phucmilo/Smart-Home-AI/SmartHome/SmartHome/Docs/SmartHome_Diagrams_page01_overview.png

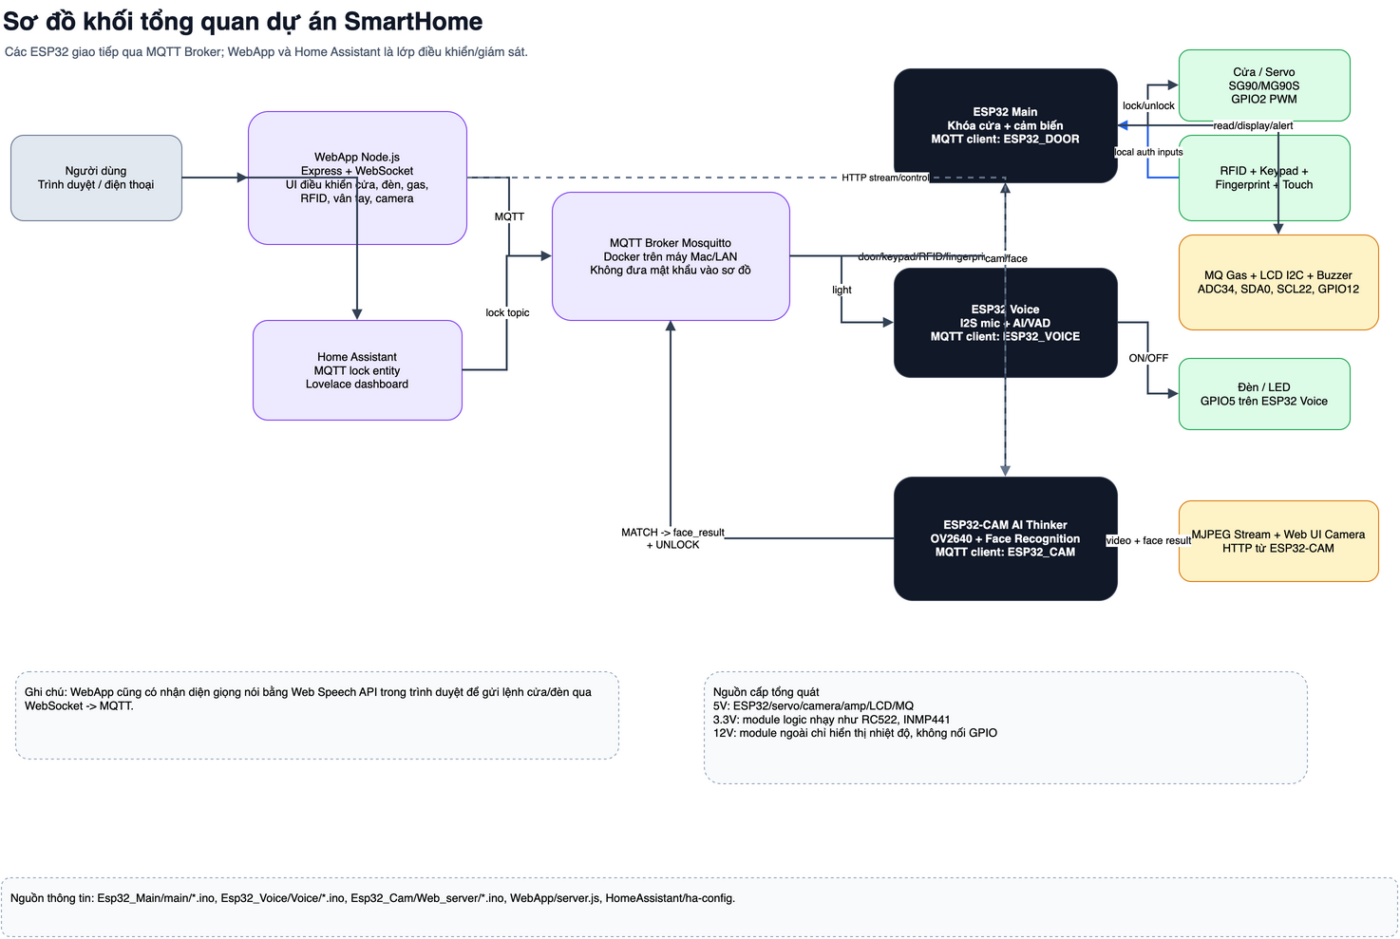
SmartHome/SmartHome/Docs/SmartHome_Diagrams_page01_overview.png
