phucmilo/Smart-Home-AI/SmartHome/SmartHome/Docs/SmartHome_Diagrams_page07_pin_main.png

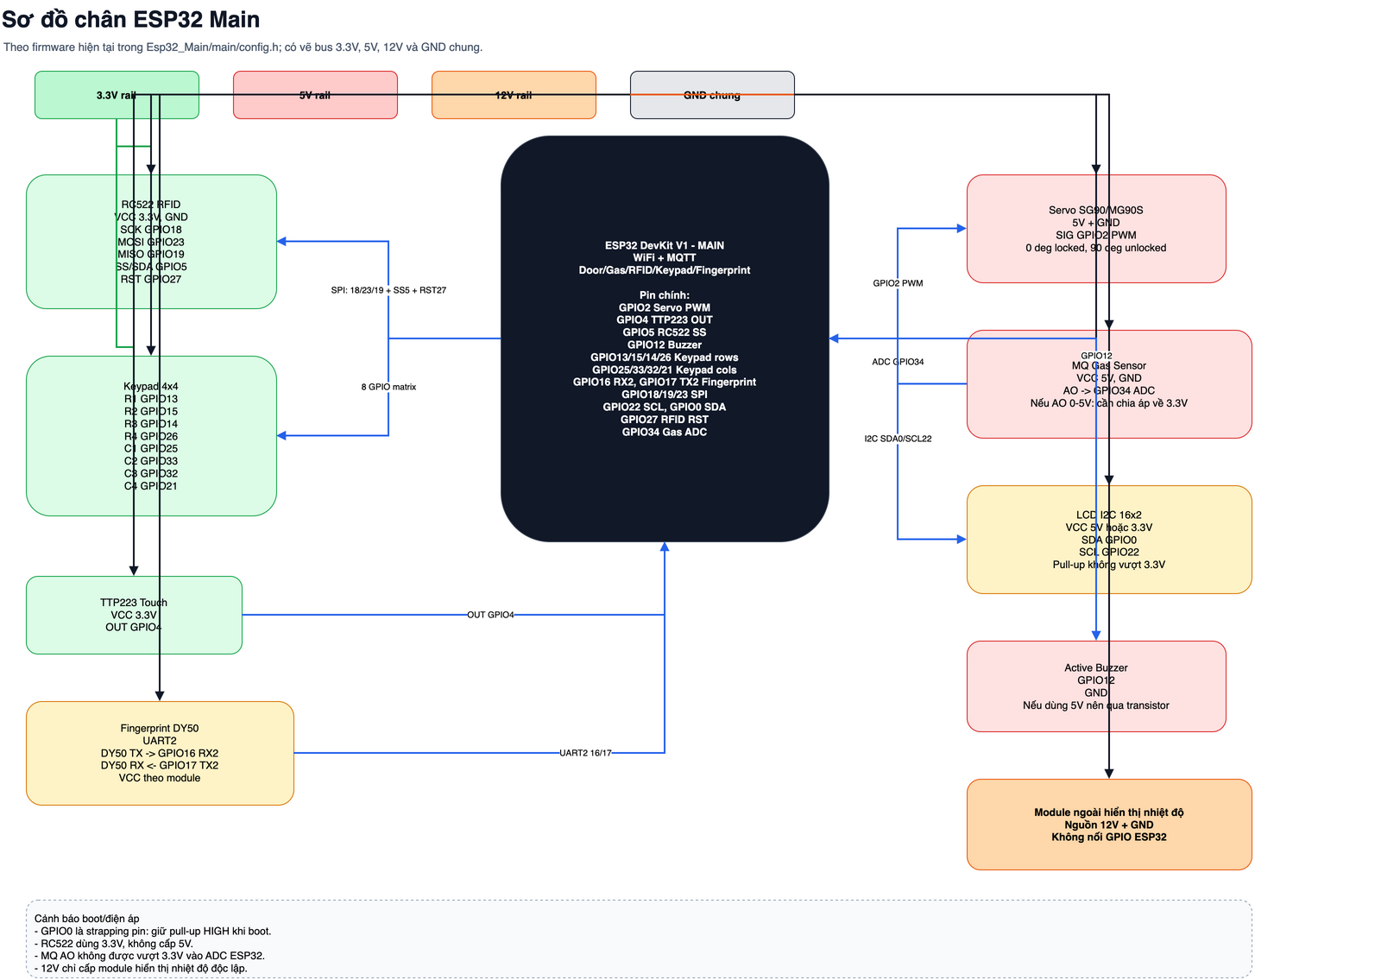
SmartHome/SmartHome/Docs/SmartHome_Diagrams_page07_pin_main.png
