phucmilo/Smart-Home-AI/SmartHome/SmartHome/Docs/SmartHome_Diagrams_page16_voice_vad.png

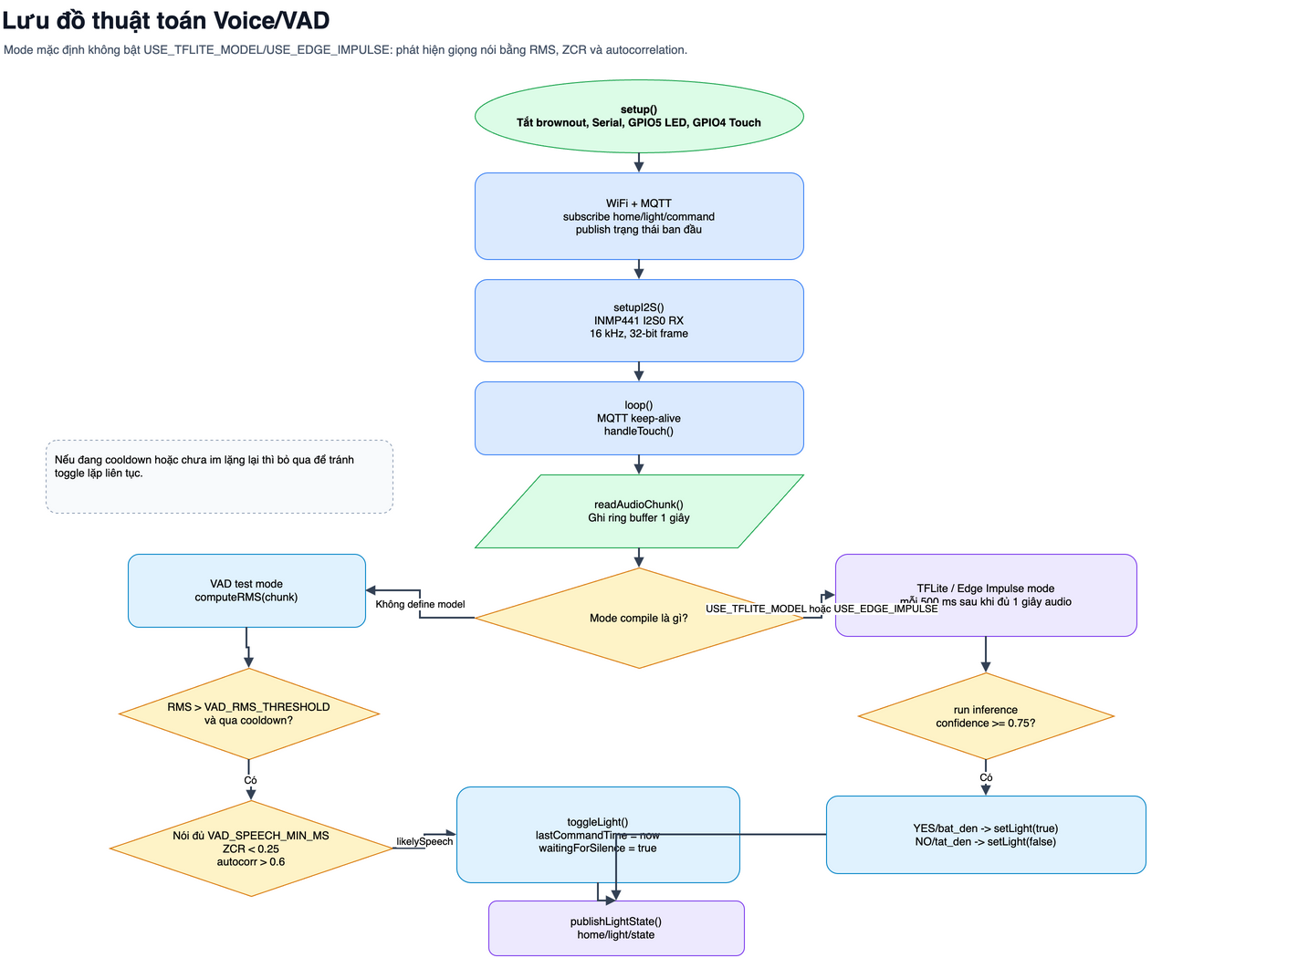
SmartHome/SmartHome/Docs/SmartHome_Diagrams_page16_voice_vad.png
