phucmilo/Smart-Home-AI/SmartHome/SmartHome/Docs/SmartHome_Diagrams.pdf

# Sơ đồ khối tổng quan dự án SmartHome

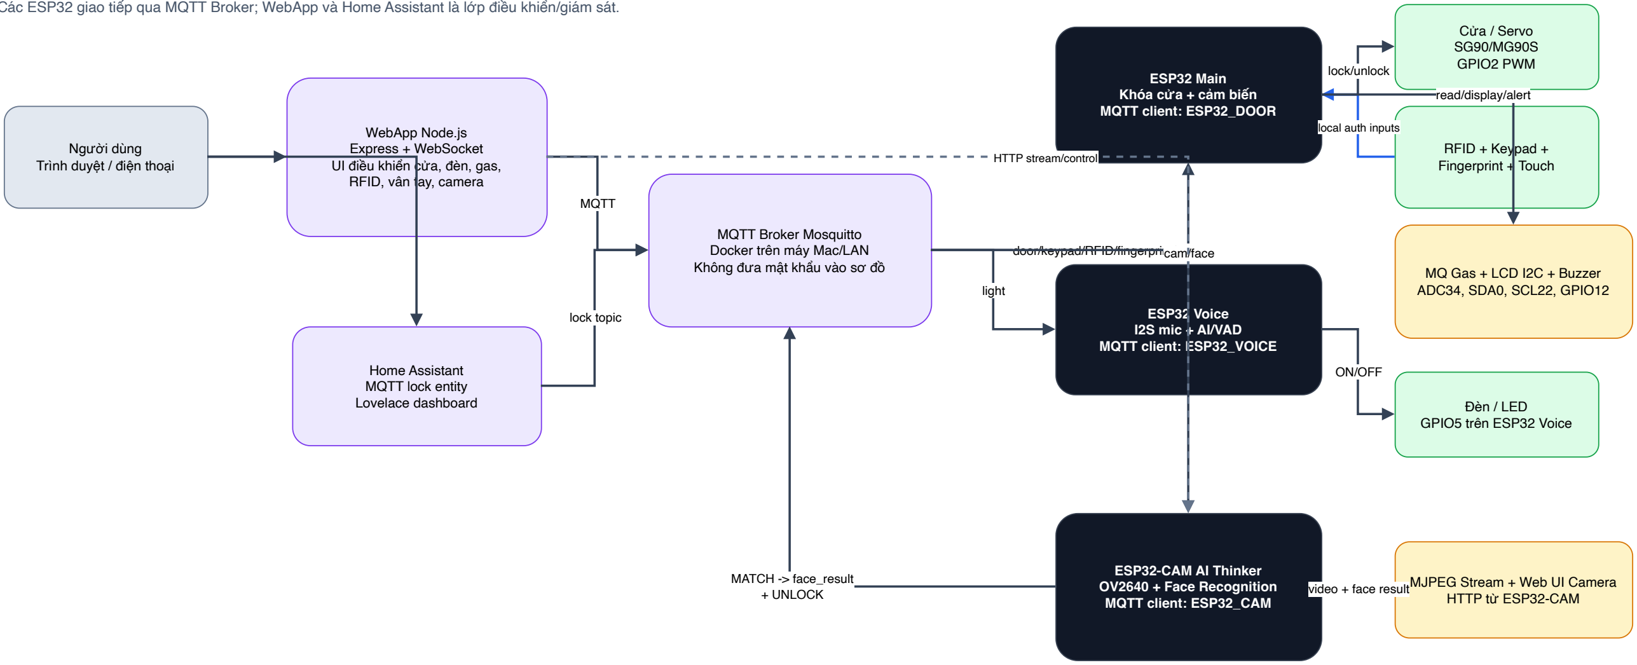
[picture p4: figure]
Người dùng Trình duyệt / điện thoại; WebApp Node.js Express + WebSocket UI điều khiển cửa, đèn, gas, RFID, vân tay, camera; Home Assistant MQTT lock entity Lovelace dashboard; MQTT Broker Mosquitto Docker trên máy Mac/LAN Không đưa mật khẩu vào sơ đồ; ESP32 Main Khóa cửa + cảm biến MQTT client: ESP32_DOOR; ESP32 Voice I2S mic + AI/VAD MQTT client: ESP32_VOICE; ESP32-CAM AI Thinker OV2640 + Face Recognition MQTT client: ESP32_CAM; Cửa / Servo SG90/MG90S GPIO2 PWM; RFID + Keypad + Fingerprint + Touch; MQ Gas + LCD I2C + Buzzer ADC34, SDA0, SCL22, GPIO12; Đèn / LED GPIO5 trên ESP32 Voice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

Các ESP32 giao tiếp qua MQTT Broker; WebApp và Home Assistant là lớp điều khiển/giám sát.

Ghi chú: WebApp cũng có nhận diện giọng nói bằng Web Speech API trong trình duyệt để gửi lệnh cửa/đèn qua WebSocket -> MQTT.

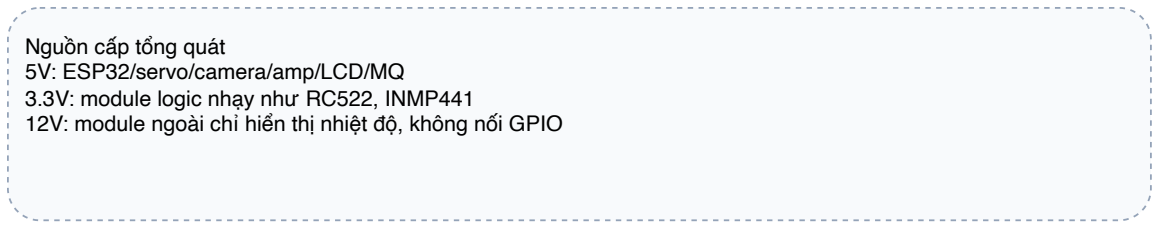
[picture p5: figure]
Nguồn cấp tổng quát 5V: ESP32/servo/camera/amp/LCD/MQ

3.3V: module logic nhạy như RC522, INMP441
12V: module ngoài chỉ hiển thị nhiệt độ, không nối GPIO

Nguồn thông tin: Esp32_Main/main/*.ino, Esp32_Voice/Voice/*.ino, Esp32_Cam/Web_server/*.ino, WebApp/server.js, HomeAssistant/ha-config.

# Sơ đồ khối MQTT topics

Luồng publish/subscribe chính giữa WebApp, Home Assistant, ESP32 Main, ESP32 Voice và ESP32-CAM.

Publisher | Topic / Payload | Subscriber / Hành động
WebApp / Home Assistant / CAM | home/door/command
Cập nhật trạng thái đèn publish | subscribe
Hiển thị tiến trình vân tay publish | subscribe
Nếu MATCH -> publish UNLOCK publish | subscribe

Lưu ý cấu hình: firmware ESP32/WebApp đang trỏ MQTT_SERVER/MQTT_URL về 192.168.88.83; Home Assistant configuration.yaml hiện đặt broker 192.168.88.150. Nếu hệ thống thực tế dùng một IP duy nhất, nên đồng bộ lại cấu hình.

# Khối khóa cửa ESP32 Main

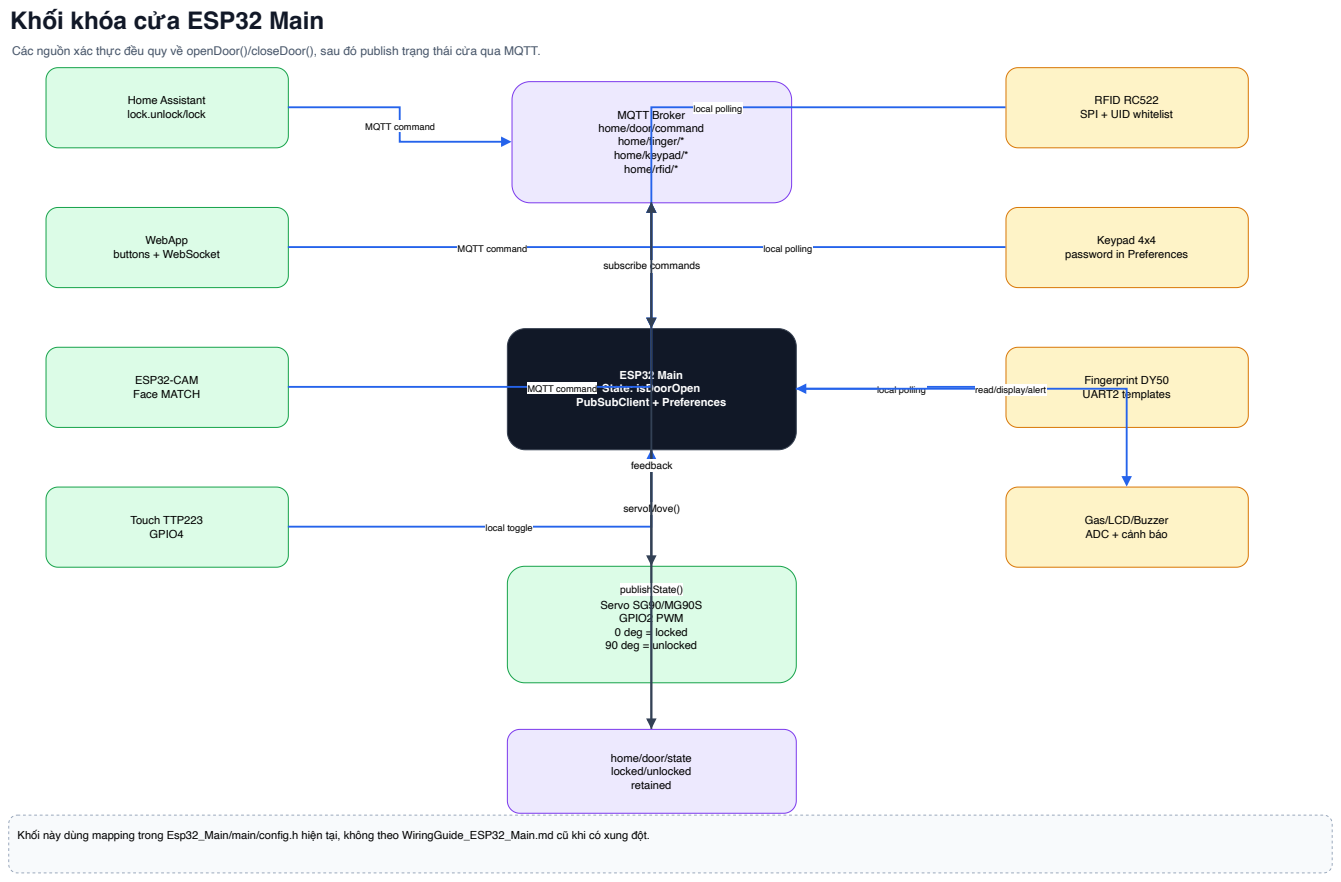
[picture p6: page 3]
ESP32 Main State: isDoorOpen PubSubClient + Preferences; MQTT command; WebApp; buttons + WebSocket; ESP32-CAM; Face MATCH; Touch TTP223; GPIO4; local toggle; RFID RC522; Keypad 4x4; Fingerprint DY50; subscribe commands; Servo SG90/MG90S GPIO2 PWM 0 deg = locked 90 deg = unlocked; servoMove(); publishState(); feedback

Các nguồn xác thực đều quy về openDoor()/closeDoor(), sau đó publish trạng thái cửa qua MQTT.

Home Assistant
lock.unlock/lock

MQTT Broker
home/door/command
home/finger/*
home/keypad/*
home/rfid/*

SPI + UID whitelist local polling

password in Preferences local polling

UART2 templates local polling

read/display/alert

Gas/LCD/Buzzer
ADC + cảnh báo

home/door/state
locked/unlocked
retained

Khối này dùng mapping trong Esp32_Main/main/config.h hiện tại, không theo WiringGuide_ESP32_Main.md cũ khi có xung đột.

# Khối điều khiển giọng nói

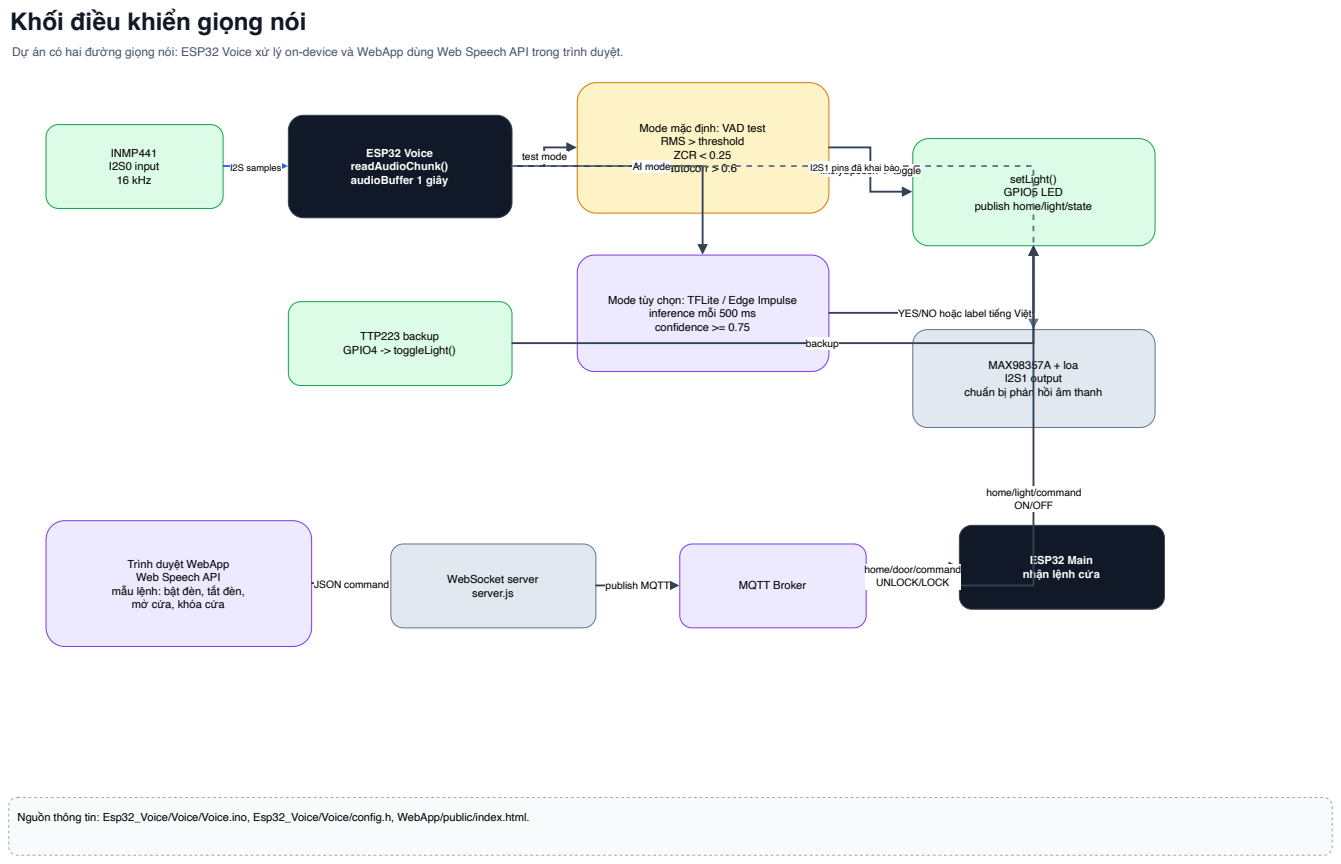
[picture p7: page 4]
INMP441 I2S0 input 16 kHz; ESP32 Voice readAudioChunk() audioBuffer 1 giây; TTP223 backup GPIO4 -> toggleLight(); MAX98357A + loa I2S1 output; WebSocket server; server.js; MQTT Broker; I2S samples; test mode; AI mode; likelySpeech -> toggle; backup; JSON command; publish MQTT

Dự án có hai đường giọng nói: ESP32 Voice xử lý on-device và WebApp dùng Web Speech API trong trình duyệt.

Mode mặc định: VAD test
RMS > threshold
ZCR < 0.25
autocorr > 0.6

I2S1 pins đã khai báo

setLight()
GPIO5 LED
publish home/light/state

Mode tùy chọn: TFLite / Edge Impulse

inference mỗi 500 ms
confidence >= 0.75

YES/NO hoặc label tiếng Việt

chuẩn bị phản hồi âm thanh

home/light/command
ON/OFF

Trình duyệt WebApp
Web Speech API
mẫu lệnh: bật đèn, tắt đèn,
mở cửa, khóa cửa

ESP32 Main
nhận lệnh cửa

home/door/command
UNLOCK/LOCK

Nguồn thông tin: Esp32_Voice/Voice/Voice.ino, Esp32_Voice/Voice/config.h, WebApp/public/index.html.

# Khối camera AI ESP32-CAM

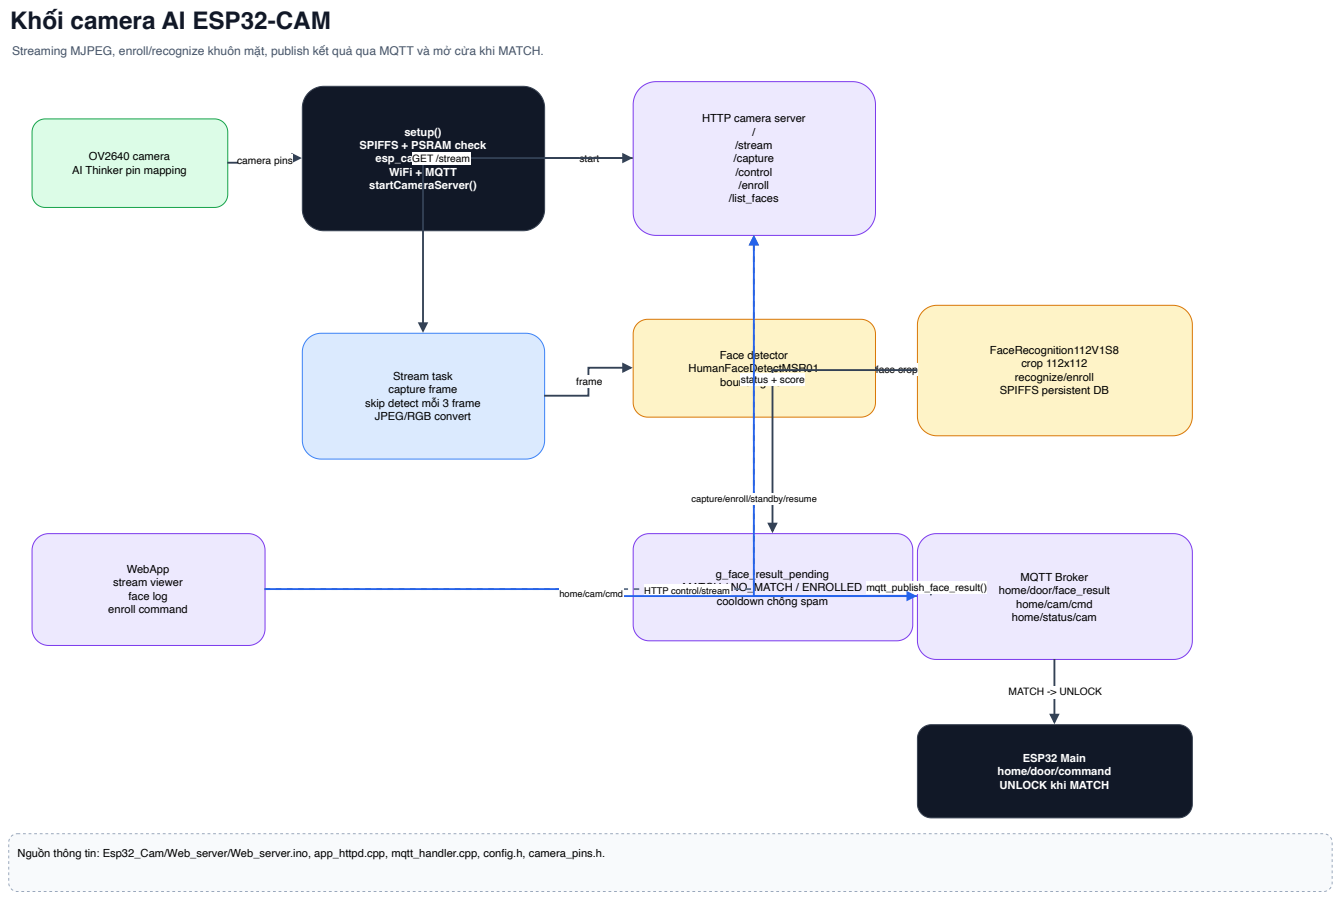
[picture p8: page 5]
setup(); / /stream /capture /control /enroll /list_faces; Face detector HumanFaceDetectMSR01 bounding box; g_face_result_pending MATCH / NO_MATCH / ENROLLED; WebApp stream viewer face log enroll command; camera pins; GET /stream; start; frame; face crop; status + score; mqtt_publish_face_result(); MATCH -> UNLOCK; home/cam/cmd; HTTP control/stream

Streaming MJPEG, enroll/recognize khuôn mặt, publish kết quả qua MQTT và mở cửa khi MATCH.

HTTP camera server

SPIFFS + PSRAM check
esp_camera_init()
WiFi + MQTT
startCameraServer()

OV2640 camera
AI Thinker pin mapping

FaceRecognition112V1S8
crop 112x112
recognize/enroll
SPIFFS persistent DB

Stream task
capture frame
skip detect mỗi 3 frame
JPEG/RGB convert

capture/enroll/standby/resume

MQTT Broker
home/door/face_result
home/cam/cmd
home/status/cam

cooldown chống spam

ESP32 Main
home/door/command
UNLOCK khi MATCH

Nguồn thông tin: Esp32_Cam/Web_server/Web_server.ino, app_httpd.cpp, mqtt_handler.cpp, config.h, camera_pins.h.

# Sơ đồ khối nguồn cấp 3.3V / 5V / 12V

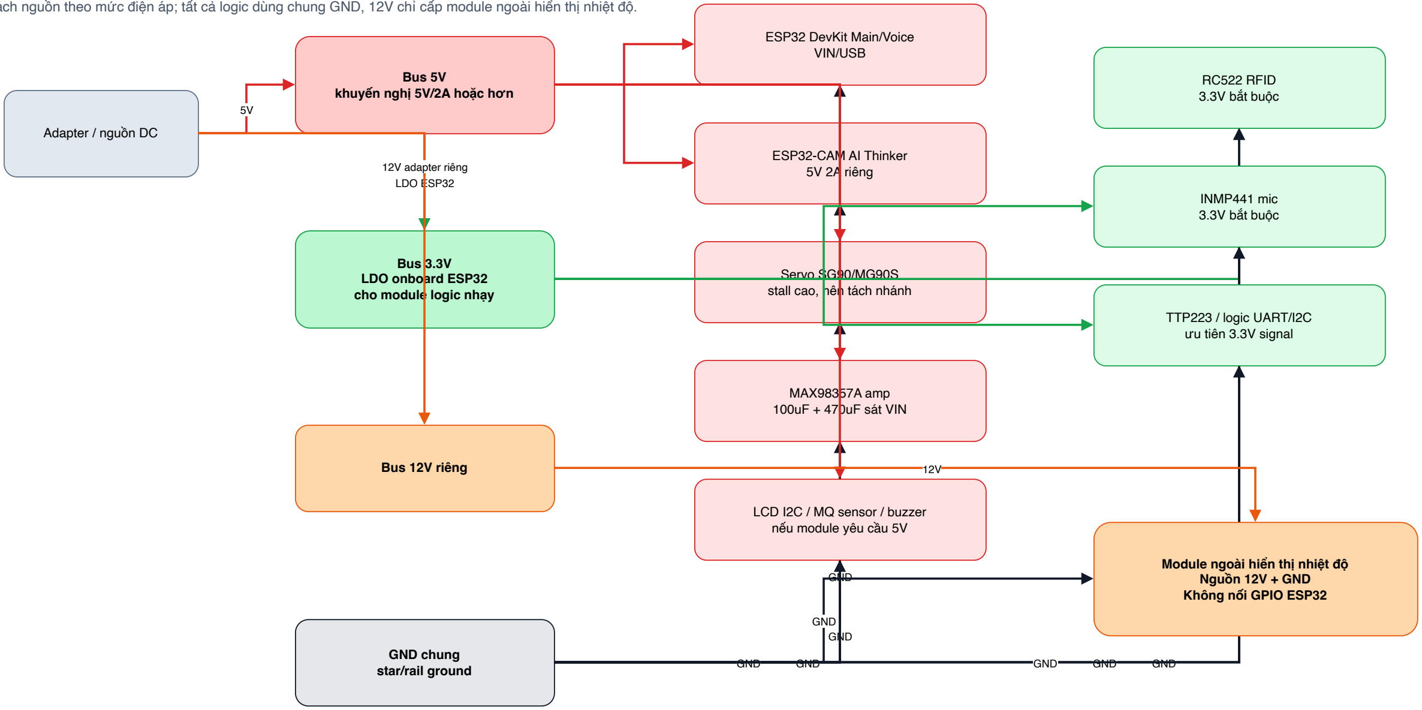
[picture p9: figure]
Adapter / nguồn DC; Bus 5V khuyến nghị 5V/2A hoặc hơn; Bus 3.3V LDO onboard ESP32 cho module logic nhạy; Bus 12V riêng; GND chung star/rail ground; LDO ESP32; 12V adapter riêng; ESP32 DevKit Main/Voice VIN/USB; GND; ESP32-CAM AI Thinker 5V 2A riêng; Servo SG90/MG90S stall cao, nên tách nhánh; MAX98357A amp 100uF + 470uF sát VIN; LCD I2C / MQ sensor / buzzer nếu module yêu cầu 5V; RC522 RFID 3.3V bắt buộc; INMP441 mic 3.3V bắt buộc; TTP223 / logic UART/I2C ưu tiên 3.3V signal; Module ngoài hiển thị nhiệt độ Nguồn 12V + GND Không nối GPIO ESP32

Tách nguồn theo mức điện áp; tất cả logic dùng chung GND, 12V chỉ cấp module ngoài hiển thị nhiệt độ.

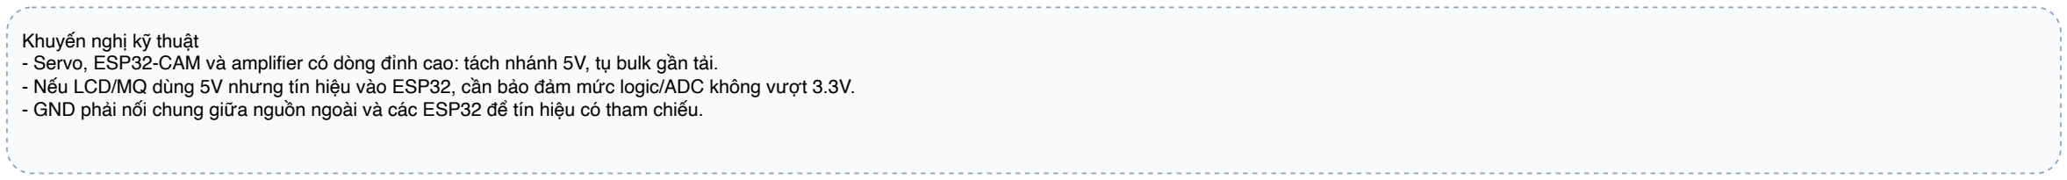
[picture p10: figure]
Khuyến nghị kỹ thuật

- Servo, ESP32-CAM và amplifier có dòng đỉnh cao: tách nhánh 5V, tụ bulk gần tải.
- Nếu LCD/MQ dùng 5V nhưng tín hiệu vào ESP32, cần bảo đảm mức logic/ADC không vượt 3.3V.
- GND phải nối chung giữa nguồn ngoài và các ESP32 để tín hiệu có tham chiếu.

# Sơ đồ chân ESP32 Main

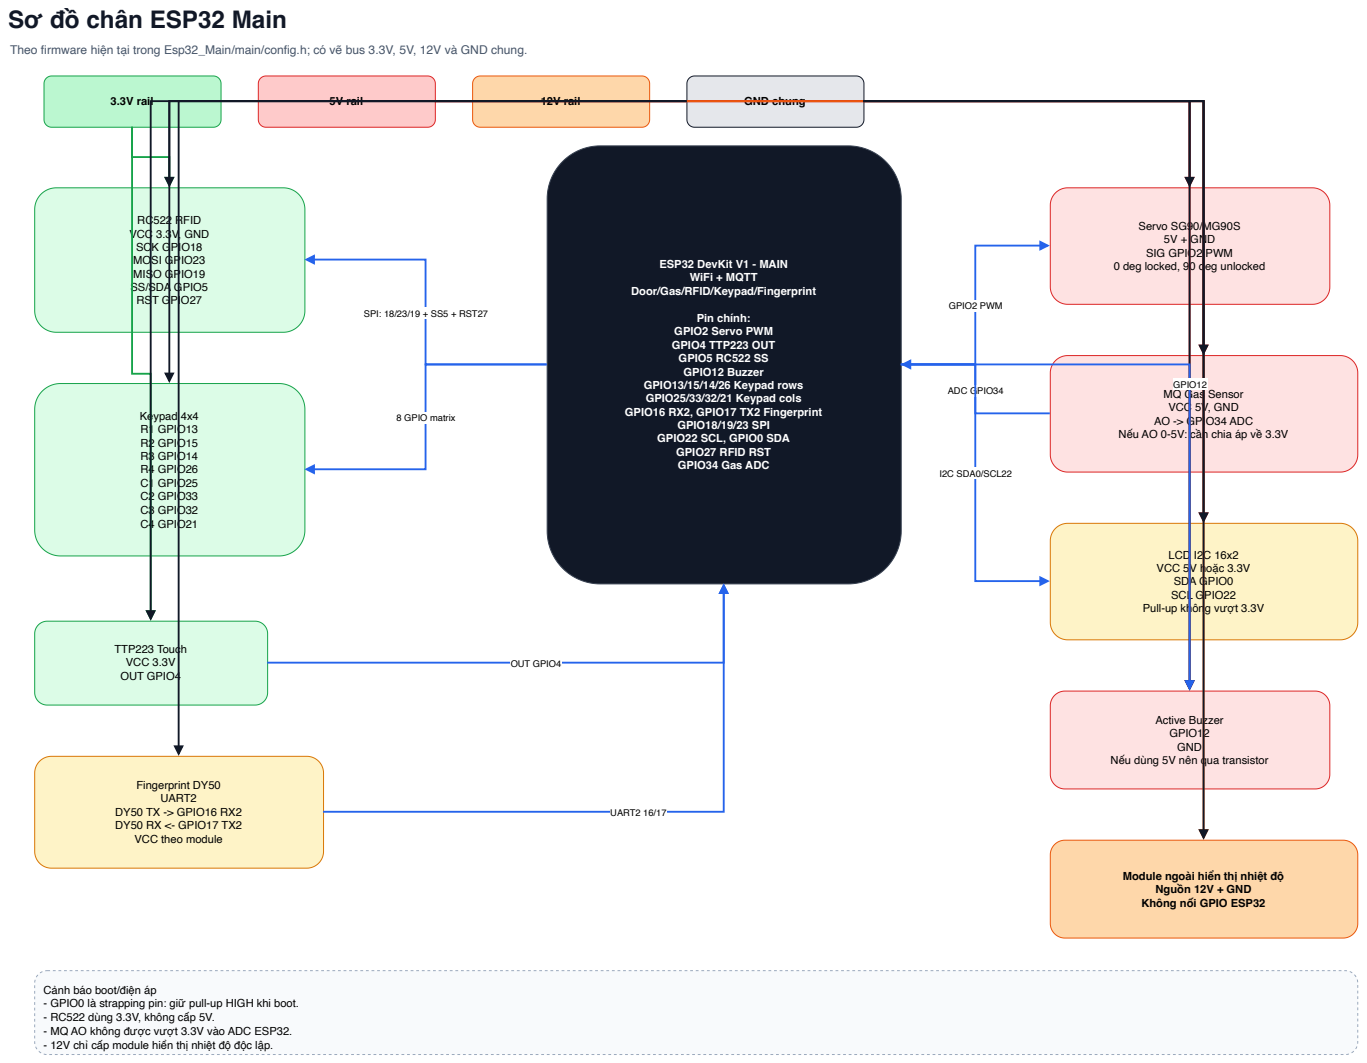
[picture p11: page 7]

Theo firmware hiện tại trong Esp32_Main/main/config.h; có vẽ bus 3.3V, 5V, 12V và GND chung.

RC522 RFID SCK GPIO18 | | | ESP32 DevKit V1 - MAIN GPIO2 Servo PWM GPIO4 TTP223 OUT | WiFi + MQTT Pin chính:

Servo SG90/MG90S
5V + GND
SIG GPIO2 PWM
0 deg locked, 90 deg unlocked

Door/Gas/RFID/Keypad/Fingerprint

GPIO5 RC522 SS GPIO18/19/23 SPI GPIO22 SCL, GPIO0 SDA GPIO27 RFID RST GPIO34 Gas ADC | GPIO12 Buzzer

Nếu AO 0-5V: cần chia áp về 3.3V

Nếu dùng 5V nên qua transistor

Module ngoài hiển thị nhiệt độ
Nguồn 12V + GND
Không nối GPIO ESP32

Cảnh báo boot/điện áp
- GPIO0 là strapping pin: giữ pull-up HIGH khi boot.
- RC522 dùng 3.3V, không cấp 5V.
- MQ AO không được vượt 3.3V vào ADC ESP32.
- 12V chỉ cấp module hiển thị nhiệt độ độc lập.

# Sơ đồ chân ESP32 Voice

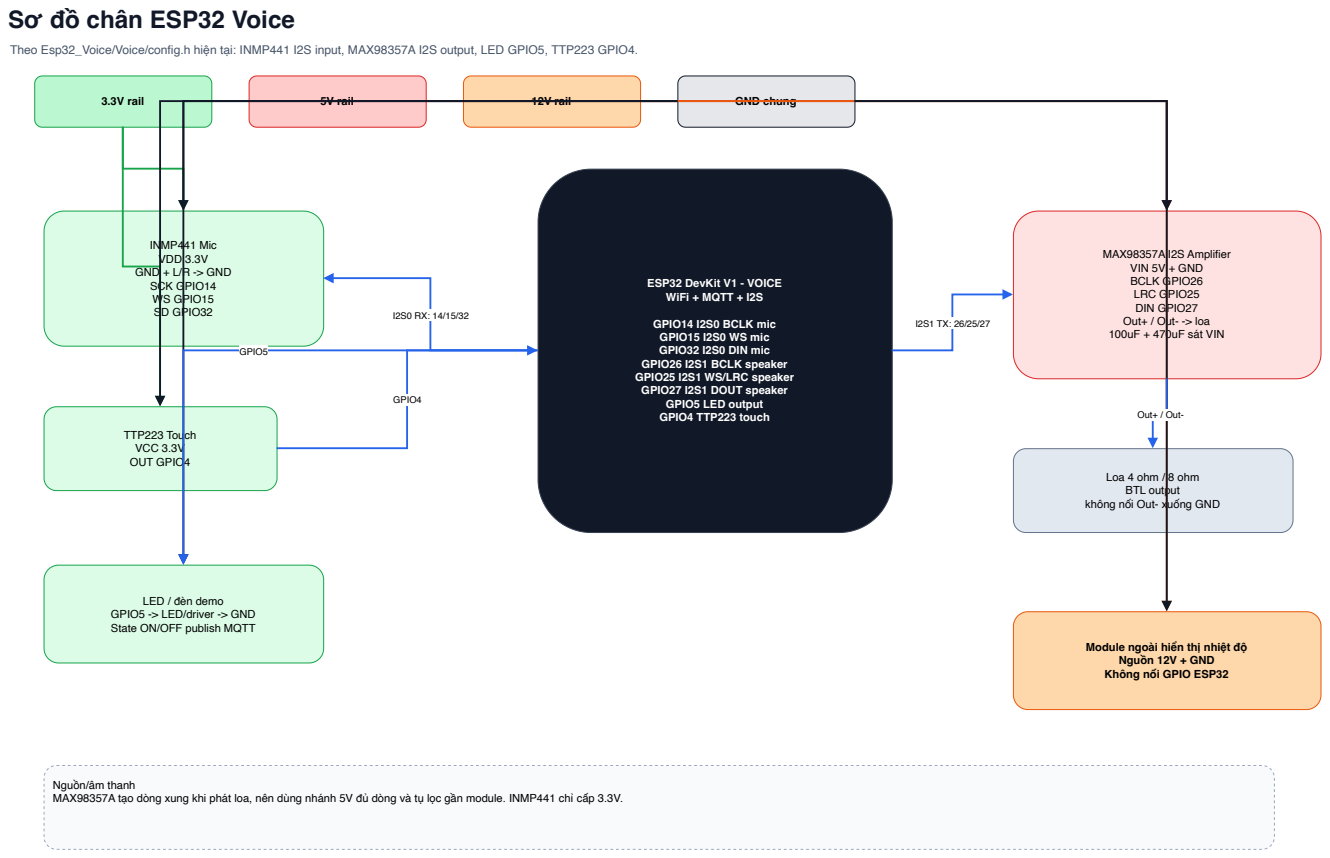
[picture p12: page 8]
ESP32 DevKit V1 - VOICE WiFi + MQTT + I2S; 3.3V rail; 5V rail; 12V rail; GND chung; SCK GPIO14 WS GPIO15 SD GPIO32; TTP223 Touch VCC 3.3V OUT GPIO4

Theo Esp32_Voice/Voice/config.h hiện tại: INMP441 I2S input, MAX98357A I2S output, LED GPIO5, TTP223 GPIO4.

INMP441 Mic GND + L/R -> GND | VDD 3.3V

MAX98357A I2S Amplifier
VIN 5V + GND
BCLK GPIO26
LRC GPIO25
DIN GPIO27
Out+ / Out- -> loa
100uF + 470uF sát VIN

GPIO14 I2S0 BCLK mic
GPIO15 I2S0 WS mic
GPIO32 I2S0 DIN mic
GPIO26 I2S1 BCLK speaker
GPIO25 I2S1 WS/LRC speaker
GPIO27 I2S1 DOUT speaker
GPIO5 LED output
GPIO4 TTP223 touch

GPIO5

GPIO4

Out+ / Out-

Loa 4 ohm / 8 ohm
BTL output

không nối Out- xuống GND

LED / đèn demo
GPIO5 -> LED/driver -> GND
State ON/OFF publish MQTT

Module ngoài hiển thị nhiệt độ
Nguồn 12V + GND
Không nối GPIO ESP32

Nguồn/âm thanh
MAX98357A tạo dòng xung khi phát loa, nên dùng nhánh 5V đủ dòng và tụ lọc gần module. INMP441 chỉ cấp 3.3V.

# Sơ đồ chân ESP32-CAM AI Thinker

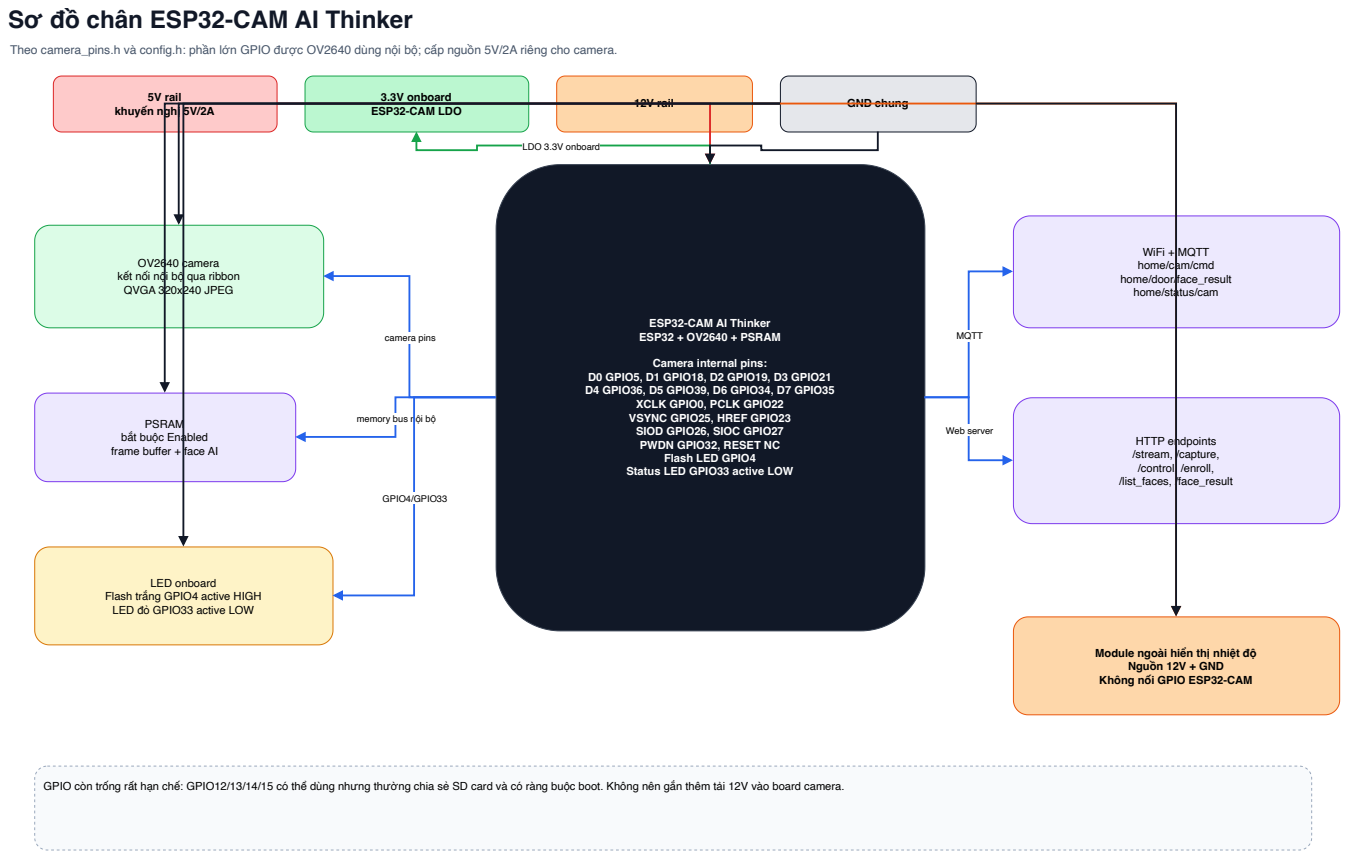
[picture p13: page 9]

Theo camera_pins.h và config.h: phần lớn GPIO được OV2640 dùng nội bộ; cấp nguồn 5V/2A riêng cho camera.

OV2640 camera
kết nối nội bộ qua ribbon
QVGA 320x240 JPEG

PSRAM
bắt buộc Enabled
frame buffer + face AI

memory bus nội bộ

Status LED GPIO33 active LOW

Flash trắng GPIO4 active HIGH
LED đỏ GPIO33 active LOW

Module ngoài hiển thị nhiệt độ
Nguồn 12V + GND
Không nối GPIO ESP32-CAM

GPIO còn trống rất hạn chế: GPIO12/13/14/15 có thể dùng nhưng thường chia sẻ SD card và có ràng buộc boot. Không nên gắn thêm tải 12V vào board camera.

# Lưu đồ thuật toán ESP32 Main loop

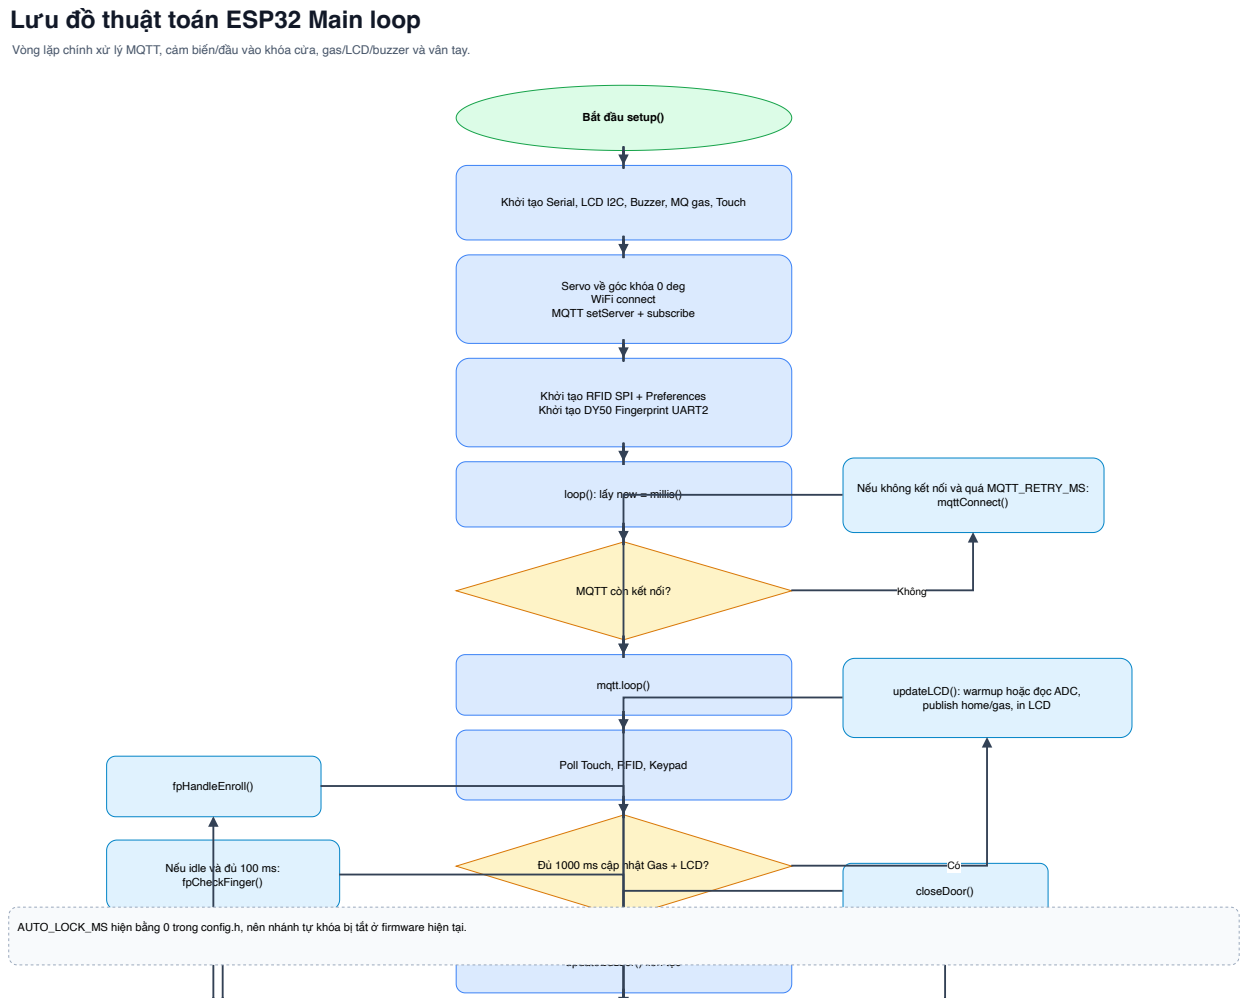
[picture p14: page 10]
mqtt.loop(); mqttConnect(); fpHandleEnroll(); closeDoor(); Không

Vòng lặp chính xử lý MQTT, cảm biến/đầu vào khóa cửa, gas/LCD/buzzer và vân tay.

Bắt đầu setup()

Khởi tạo Serial, LCD I2C, Buzzer, MQ gas, Touch

Servo về góc khóa 0 deg
WiFi connect

MQTT setServer + subscribe

Khởi tạo RFID SPI + Preferences
Khởi tạo DY50 Fingerprint UART2

Nếu không kết nối và quá MQTT_RETRY_MS:

loop(): lấy now = millis()

MQTT còn kết nối?

updateLCD(): warmup hoặc đọc ADC,
publish home/gas, in LCD

Poll Touch, RFID, Keypad

Nếu idle và đủ 100 ms:
fpCheckFinger()

Đủ 1000 ms cập nhật Gas + LCD?

AUTO_LOCK_MS hiện bằng 0 trong config.h, nên nhánh tự khóa bị tắt ở firmware hiện tại.

updateBuzzer() liên tục

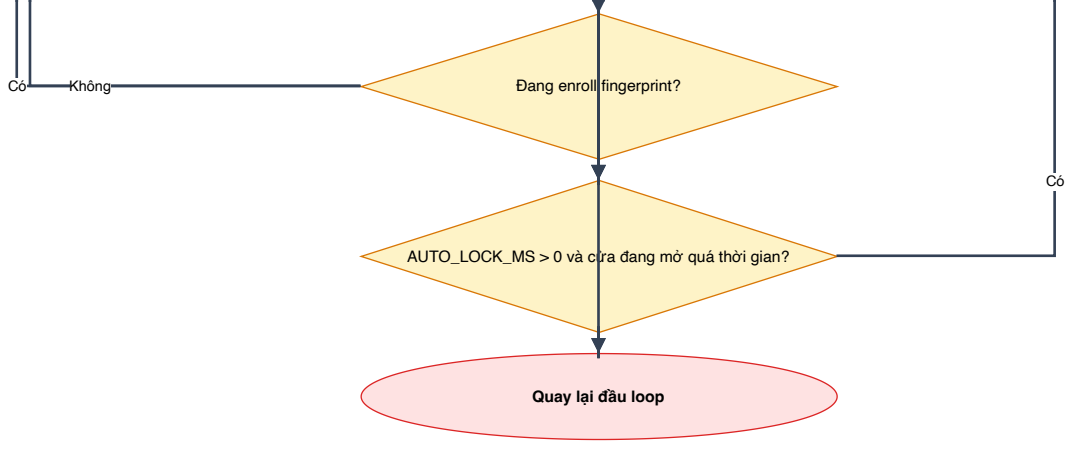
[picture p15: page 11]
Không

Đang enroll fingerprint?

AUTO_LOCK_MS > 0 và cửa đang mở quá thời gian?

Quay lại đầu loop

# Lưu đồ thuật toán điều khiển cửa

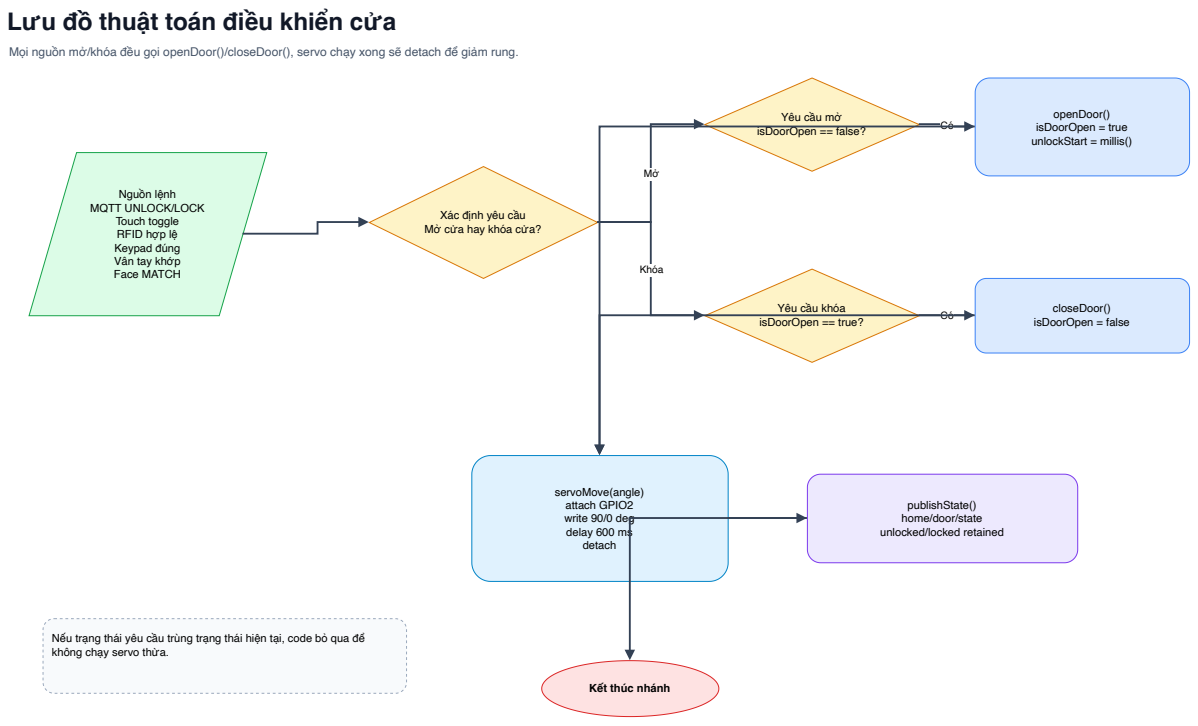
[picture p16: page 12]
openDoor() isDoorOpen = true unlockStart = millis(); closeDoor() isDoorOpen = false; servoMove(angle) attach GPIO2 write 90/0 deg delay 600 ms detach; Khóa

Mọi nguồn mở/khóa đều gọi openDoor()/closeDoor(), servo chạy xong sẽ detach để giảm rung.

Yêu cầu mở
isDoorOpen == false?

Nguồn lệnh
MQTT UNLOCK/LOCK
Touch toggle
RFID hợp lệ
Keypad đúng
Vân tay khớp
Face MATCH

Xác định yêu cầu
Mở cửa hay khóa cửa?

Yêu cầu khóa
isDoorOpen == true?

publishState()
home/door/state
unlocked/locked retained

Nếu trạng thái yêu cầu trùng trạng thái hiện tại, code bỏ qua để
không chạy servo thừa.

Kết thúc nhánh

# Lưu đồ thuật toán RFID RC522

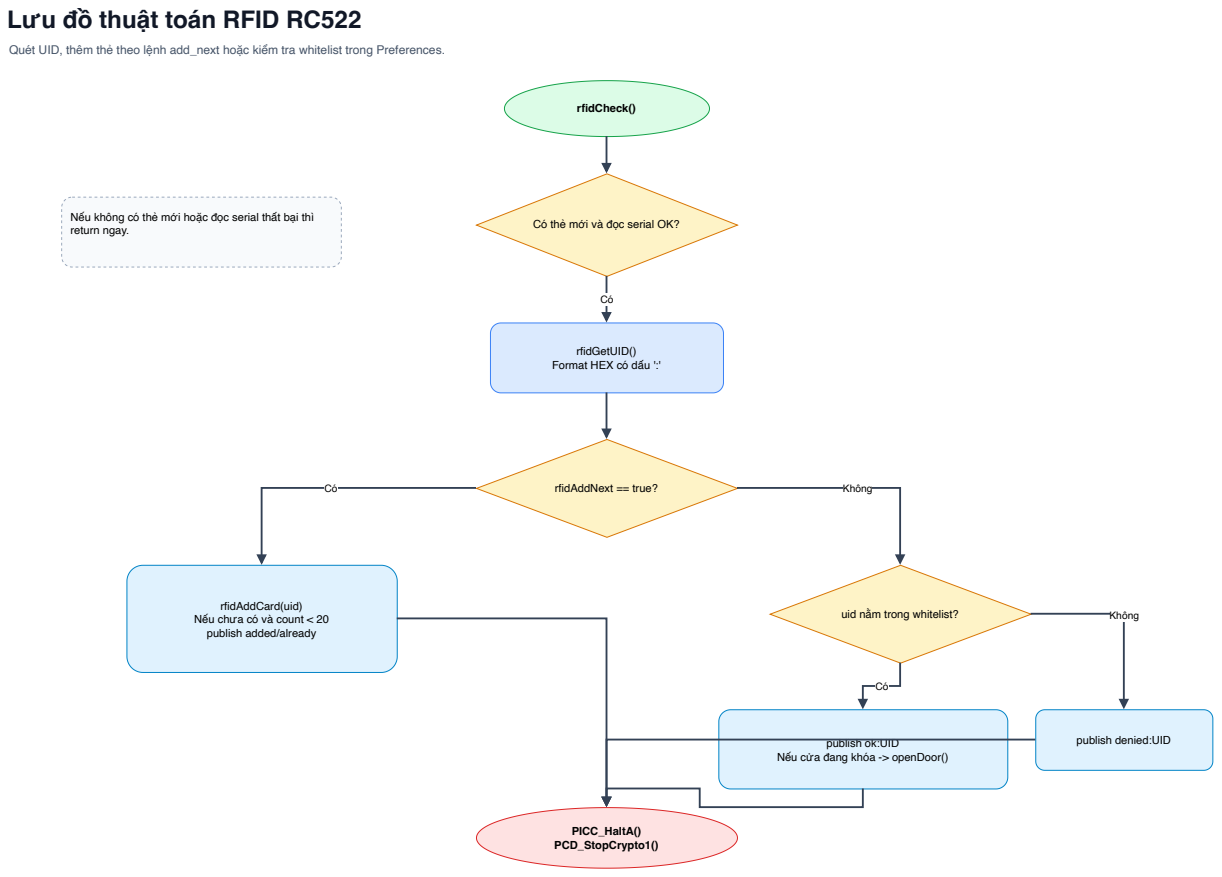
[picture p17: page 13]
rfidCheck(); rfidAddNext == true?; PICC_HaltA() PCD_StopCrypto1(); Không

Quét UID, thêm thẻ theo lệnh add_next hoặc kiểm tra whitelist trong Preferences.

Nếu không có thẻ mới hoặc đọc serial thất bại thì
return ngay.

Có thẻ mới và đọc serial OK?

rfidGetUID()
Format HEX có dấu ':'

rfidAddCard(uid)
Nếu chưa có và count < 20
publish added/already

uid nằm trong whitelist?

publish ok:UID

publish denied:UID

Nếu cửa đang khóa -> openDoor()

# Lưu đồ thuật toán Keypad 4x4

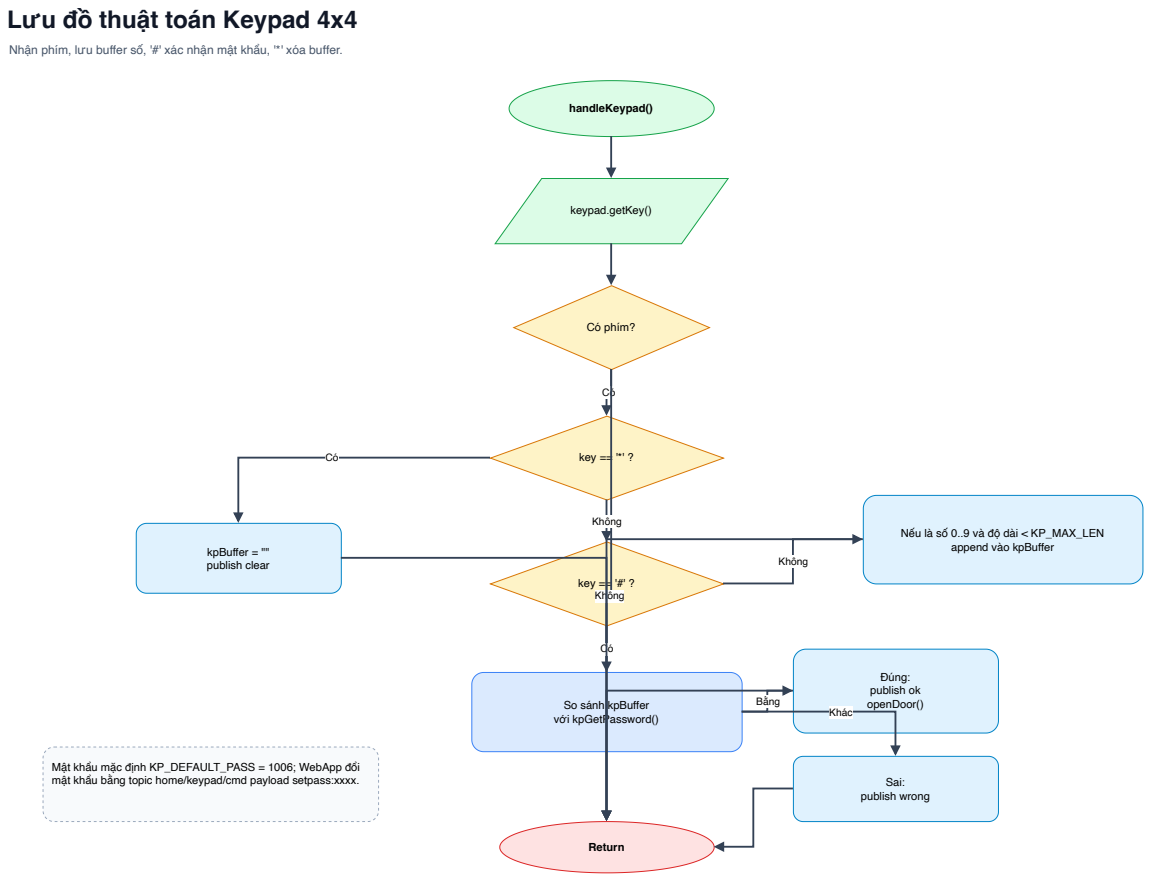
[picture p18: page 14]
handleKeypad(); keypad.getKey(); Có phím?; key == '*' ?; kpBuffer = "" publish clear; key == '#' ?; Đúng: publish ok openDoor(); Sai: publish wrong; Return; Không; Bằng; Khác

Nhận phím, lưu buffer số, '#' xác nhận mật khẩu, '*' xóa buffer.

Nếu là số 0..9 và độ dài < KP_MAX_LEN

append vào kpBuffer

So sánh kpBuffer
với kpGetPassword()

Mật khẩu mặc định KP_DEFAULT_PASS = 1006; WebApp đổi
mật khẩu bằng topic home/keypad/cmd payload setpass:xxxx.

# Lưu đồ thuật toán vân tay DY50

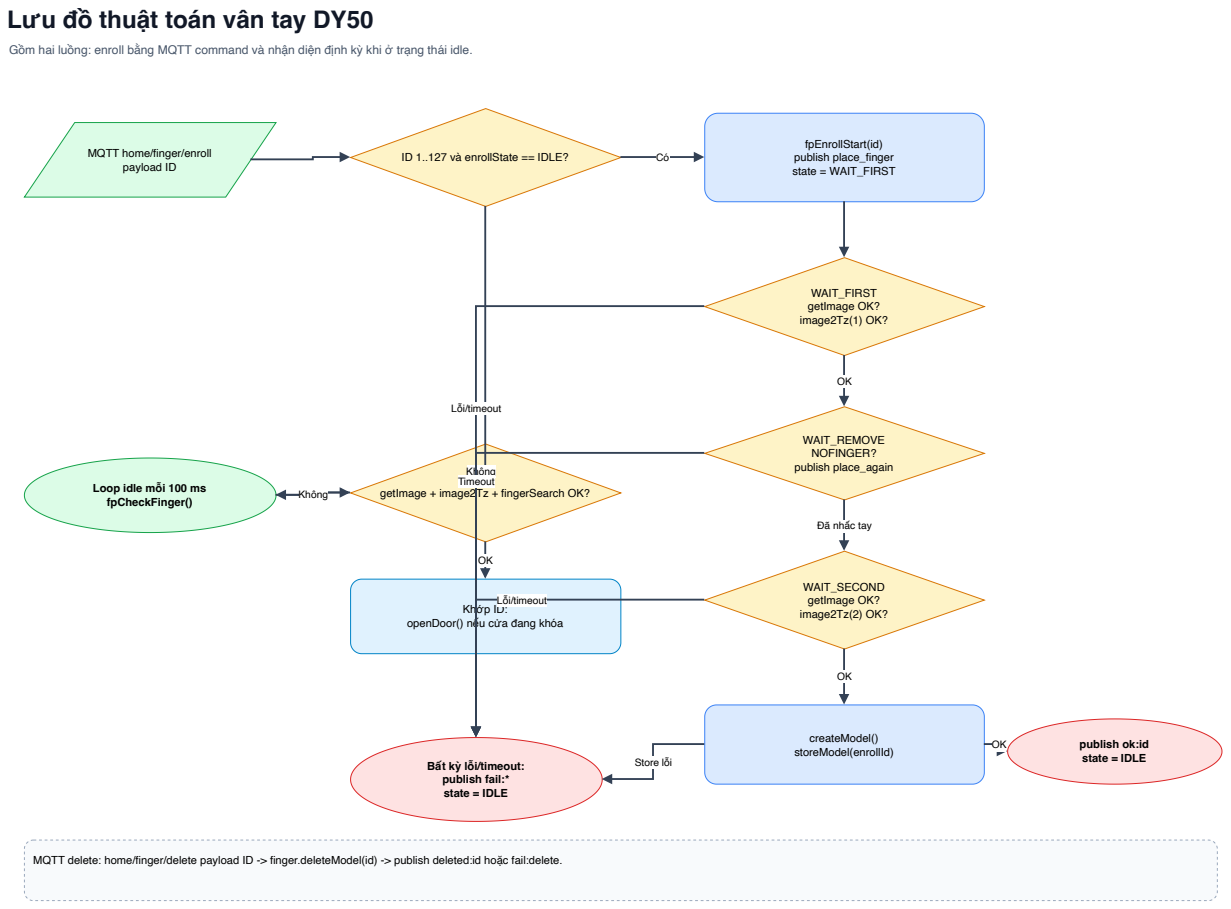
[picture p19: page 15]
payload ID; fpEnrollStart(id) publish place_finger state = WAIT_FIRST; WAIT_FIRST getImage OK? image2Tz(1) OK?; WAIT_REMOVE NOFINGER? publish place_again; WAIT_SECOND getImage OK? image2Tz(2) OK?; createModel(); storeModel(enrollId); publish ok:id; Khớp ID:; Không; Lỗi/timeout; Timeout; Store lỗi

Gồm hai luồng: enroll bằng MQTT command và nhận diện định kỳ khi ở trạng thái idle.

MQTT home/finger/enroll

ID 1..127 và enrollState == IDLE?

Loop idle mỗi 100 ms
fpCheckFinger()

getImage + image2Tz + fingerSearch OK?

Đã nhấc tay

openDoor() nếu cửa đang khóa

state = IDLE Bất kỳ lỗi/timeout:
publish fail:*
state = IDLE

MQTT delete: home/finger/delete payload ID -> finger.deleteModel(id) -> publish deleted:id hoặc fail:delete.

# Lưu đồ thuật toán Gas + LCD + Buzzer

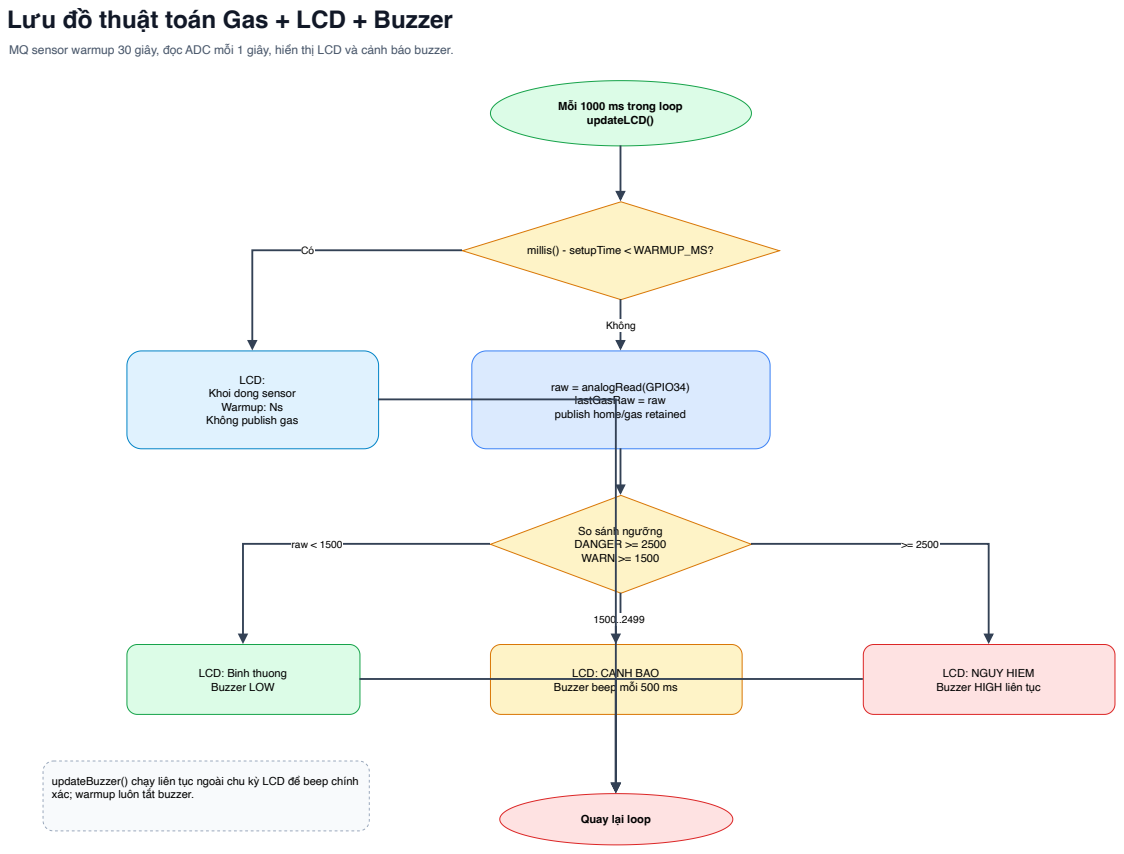
[picture p20: page 16]
millis() - setupTime < WARMUP_MS?; Không; raw < 1500

MQ sensor warmup 30 giây, đọc ADC mỗi 1 giây, hiển thị LCD và cảnh báo buzzer.

Mỗi 1000 ms trong loop
updateLCD()

LCD:
Khoi dong sensor
Warmup: Ns
Không publish gas

raw = analogRead(GPIO34)
lastGasRaw = raw
publish home/gas retained

So sánh ngưỡng
DANGER >= 2500
WARN >= 1500

LCD: Binh thuong
Buzzer LOW

LCD: CANH BAO
Buzzer beep mỗi 500 ms

LCD: NGUY HIEM
Buzzer HIGH liên tục

updateBuzzer() chạy liên tục ngoài chu kỳ LCD để beep chính
xác; warmup luôn tắt buzzer.

Quay lại loop

# Lưu đồ thuật toán Voice/VAD

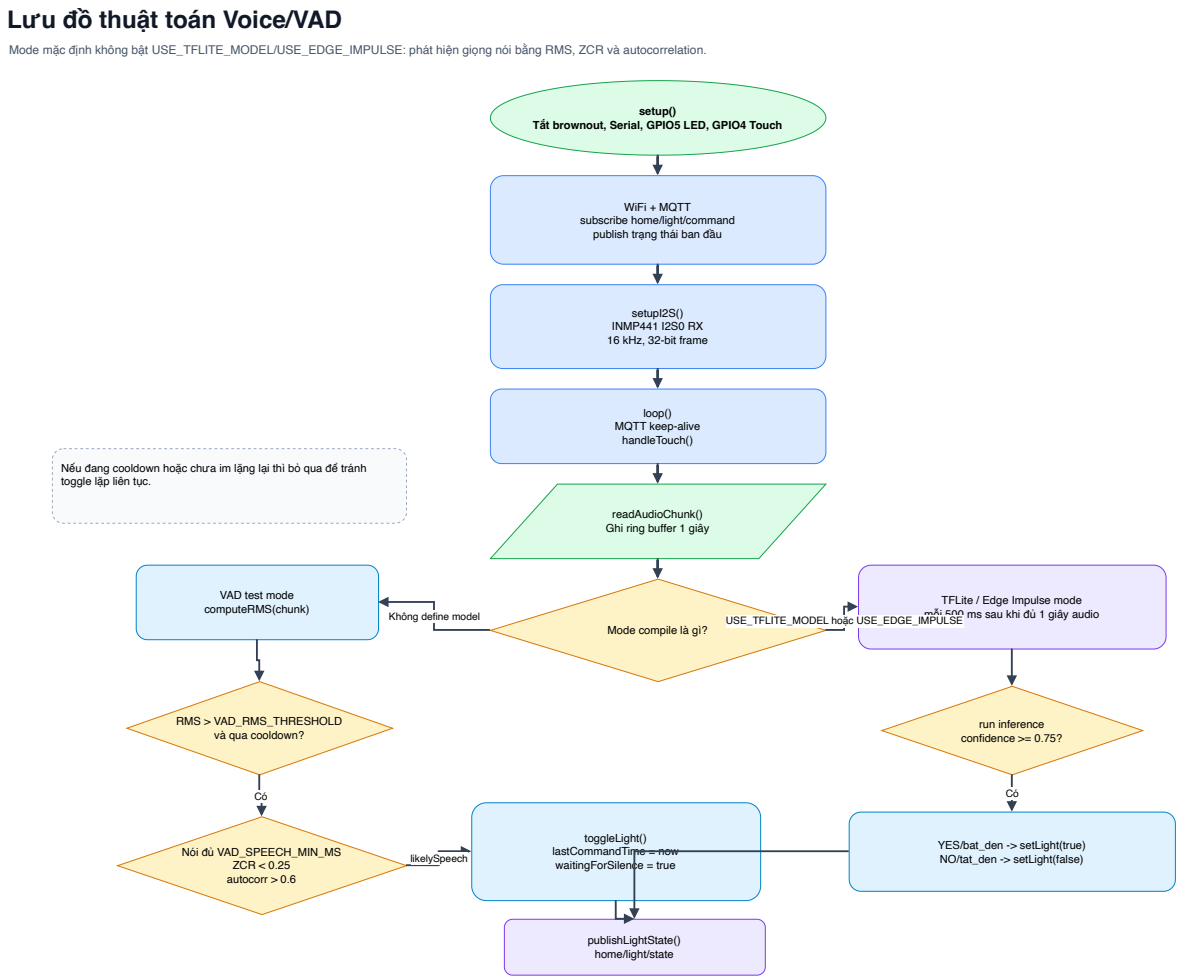
[picture p21: page 17]
setup(); WiFi + MQTT; setupI2S() INMP441 I2S0 RX 16 kHz, 32-bit frame; RMS > VAD_RMS_THRESHOLD; Nói đủ VAD_SPEECH_MIN_MS ZCR < 0.25 autocorr > 0.6; toggleLight() lastCommandTime = now waitingForSilence = true; run inference confidence >= 0.75?; likelySpeech; USE_TFLITE_MODEL hoặc USE_EDGE_IMPULSE

Mode mặc định không bật USE_TFLITE_MODEL/USE_EDGE_IMPULSE: phát hiện giọng nói bằng RMS, ZCR và autocorrelation.

Tắt brownout, Serial, GPIO5 LED, GPIO4 Touch

subscribe home/light/command
publish trạng thái ban đầu

loop()
MQTT keep-alive
handleTouch()

Nếu đang cooldown hoặc chưa im lặng lại thì bỏ qua để tránh
toggle lặp liên tục.

readAudioChunk()
Ghi ring buffer 1 giây

VAD test mode
computeRMS(chunk)

TFLite / Edge Impulse mode
mỗi 500 ms sau khi đủ 1 giây audio

Không define model

Mode compile là gì?

và qua cooldown?

YES/bat_den -> setLight(true)
NO/tat_den -> setLight(false)

publishLightState()
home/light/state

# Lưu đồ thuật toán ESP32-CAM Face Recognition

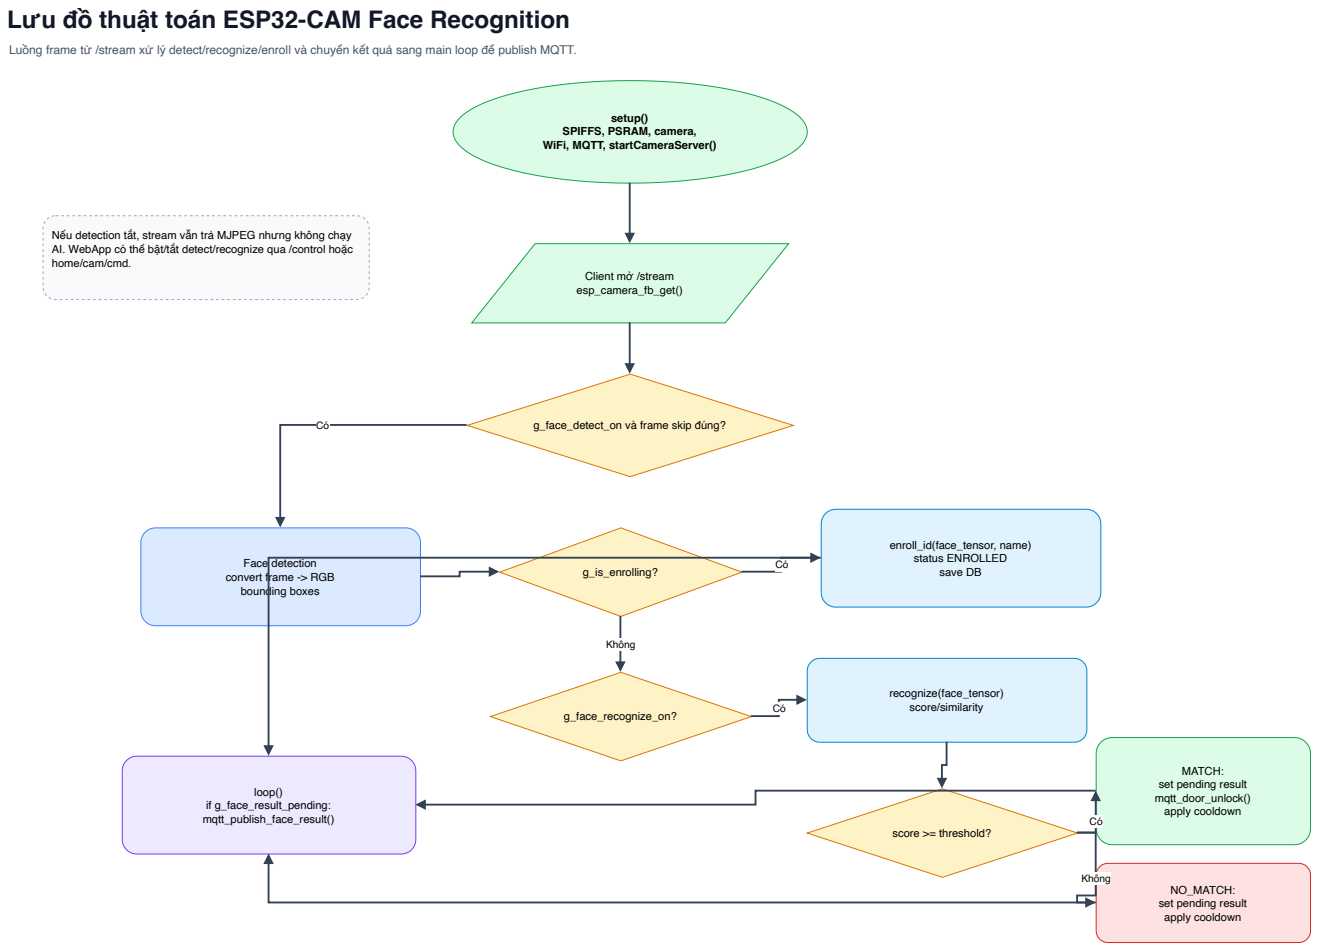
[picture p22: page 18]
setup(); g_is_enrolling?; enroll_id(face_tensor, name) status ENROLLED save DB; g_face_recognize_on?; recognize(face_tensor) score/similarity; score >= threshold?; loop() if g_face_result_pending: mqtt_publish_face_result(); Không

Luồng frame từ /stream xử lý detect/recognize/enroll và chuyển kết quả sang main loop để publish MQTT.

SPIFFS, PSRAM, camera,
WiFi, MQTT, startCameraServer()

Nếu detection tắt, stream vẫn trả MJPEG nhưng không chạy
AI. WebApp có thể bật/tắt detect/recognize qua /control hoặc
home/cam/cmd.

Client mở /stream
esp_camera_fb_get()

g_face_detect_on và frame skip đúng?

Face detection
convert frame -> RGB
bounding boxes

MATCH:
set pending result
mqtt_door_unlock()
apply cooldown

NO_MATCH:

# Lưu đồ thuật toán WebApp MQTT bridge

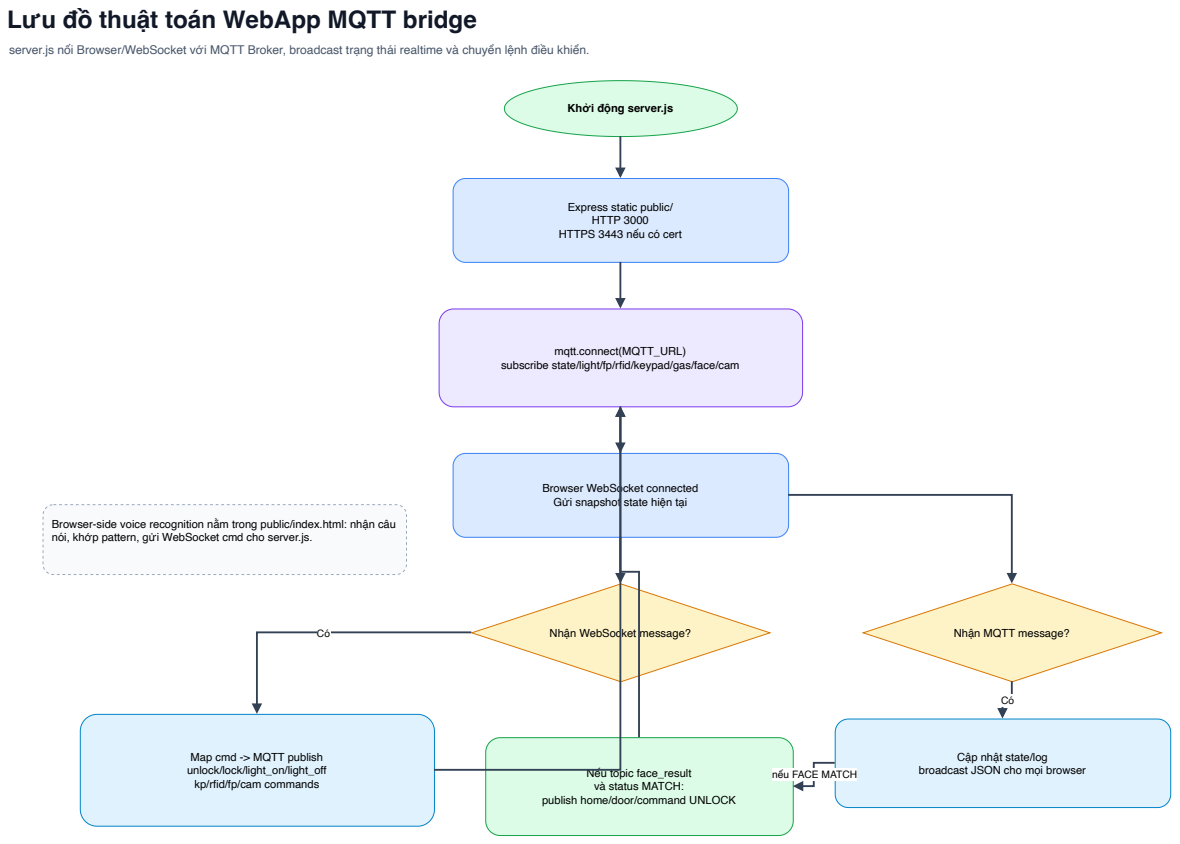
[picture p23: page 19]
mqtt.connect(MQTT_URL); Nếu topic face_result; broadcast JSON cho mọi browser

server.js nối Browser/WebSocket với MQTT Broker, broadcast trạng thái realtime và chuyển lệnh điều khiển.

Khởi động server.js

Express static public/
HTTP 3000

HTTPS 3443 nếu có cert

subscribe state/light/fp/rfid/keypad/gas/face/cam

Browser WebSocket connected
Gửi snapshot state hiện tại

Browser-side voice recognition nằm trong public/index.html: nhận câu
nói, khớp pattern, gửi WebSocket cmd cho server.js.

Nhận WebSocket message?

Nhận MQTT message?

Map cmd -> MQTT publish
unlock/lock/light_on/light_off
kp/rfid/fp/cam commands

Cập nhật state/log

và status MATCH:

nếu FACE MATCH

publish home/door/command UNLOCK
